Rivercraft911/PEEP/PCB/peep/production/REV1.1_bom.csv

Designator | Footprint | Quantity | Value | LCSC Part #
C2, C3 | 0402 | 2 | 1uF
C5, C7 | 0402 | 2 | 100nF
C6 | 0603 | 1 | 4.7uF
D1 | VEMD10940F | 1 | VEMD10940F | VEMD10940F
J1 | PCB_USBA | 1 | USB_A
R1 | 0402 | 1 | 10k
R2, R3 | Spacer_0805_SideMount_RC0805JR-070RL | 2 | R_US | C96345
TP1, TP2 | TestPoint-1.0mm | 2 | TestPoint
U1 | ST_UFQFPN28_4x4mm_P0.5mm | 1 | STM32F042G6Ux
U2 | Texas_X2SON-4_1x1mm_P0.65mm | 1 | TPS7A0233DQNR
U3 | VSOP38338 | 1 | VSOP38338 | VSOP38338
