Rivercraft911/PEEP/PCB/peep/peep.kicad_pcb

## KiCad design PCB/peep/peep.kicad_pcb (2026-08-11)

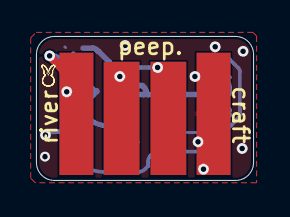
[picture p6: board peep.kicad_pcb from above]

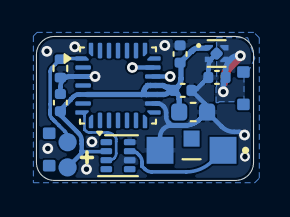
[picture p7: board peep.kicad_pcb from below]

Board: 4 copper layers, 12.1 x 8.0 mm, 15 parts (14 on the bottom side), 8 nets.

Parts:
C2, C3: 1uF; C_0402_1005Metric
C5, C7: 100nF; C_0402_1005Metric
C6: 4.7uF; C_0603_1608Metric
D1: VEMD10940F
J1: USB_A; PCB_USBA
R1: 10k; R_0402_1005Metric
R2, R3: R_US; Spacer_0805_SideMount_RC0805JR-070RL
TP1, TP2: TestPoint; TestPoint-1.0mm
U1: STM32F042G6Ux; ST_UFQFPN28_4x4mm_P0.5mm
U2: TPS7A0233DQNR; Texas_X2SON-4_1x1mm_P0.65mm
U3: VSOP38338

Connections:
+3V3: C3.2, C5.2, C6.2, C7.2, TP2.1 (1_1), U1.5 (VDDA), U1.17 (VDD), U1.18 (VDDIO2), U2.1 (OUT), U3.2 (VS)
+5V: C2.1, J1.1 (VBUS), U2.3 (EN), U2.4 (IN)
/BOOT0: R1.2, TP1.1 (1_1), U1.1 (PB8)
/OptoOut: U1.7 (PA1), U3.3 (~OUT)
/USB_D+: J1.3 (D+), U1.20 (PA10/PA12)
/USB_D-: J1.2 (D-), U1.19 (PA9/PA11)
GND: C2.2, C3.1, C5.1, C6.1, C7.1, D1.A, J1.4 (GND), R1.1, U1.3 (PF1), U1.16 (VSSA), U2.2 (GND), U2.5 (EP), U3.6 (GND), U3.8 (GND)
unnamed: D1.C, U3.7 (IN)
