Rivercraft911/PEEP/software/firmware/src/board.c

#include "board.h"

#include "stm32f0xx.h"

static volatile uint32_t ticks;

static void clock_init(void)
{
    FLASH->ACR = FLASH_ACR_PRFTBE | FLASH_ACR_LATENCY;

    RCC->CR2 |= RCC_CR2_HSI48ON;
    while ((RCC->CR2 & RCC_CR2_HSI48RDY) == 0U) {
    }

    RCC->CFGR = (RCC->CFGR & ~(RCC_CFGR_SW | RCC_CFGR_HPRE | RCC_CFGR_PPRE)) |
                RCC_CFGR_SW_HSI48;
    while ((RCC->CFGR & RCC_CFGR_SWS) != RCC_CFGR_SWS_HSI48) {
    }

    SystemCoreClock = 48000000U;
    RCC->AHBENR |= RCC_AHBENR_GPIOAEN;
    RCC->APB2ENR |= RCC_APB2ENR_SYSCFGEN;
    RCC->APB1ENR |= RCC_APB1ENR_CRSEN | RCC_APB1ENR_USBEN;
    RCC->CFGR3 &= ~RCC_CFGR3_USBSW;

    SYSCFG->CFGR1 |= SYSCFG_CFGR1_PA11_PA12_RMP;
    CRS->CFGR = 47999U | (34U << CRS_CFGR_FELIM_Pos) | CRS_CFGR_SYNCSRC_1;
    CRS->CR |= CRS_CR_AUTOTRIMEN | CRS_CR_CEN;
}

void board_init(void)
{
    clock_init();
    SysTick_Config(SystemCoreClock / 1000U);
}

uint32_t board_millis(void)
{
    return ticks;
}

/* Run from RAM while erasing the first flash page to force ROM boot on reset. */
__attribute__((section(".ramfunc"), noinline)) void board_enter_bootloader(void)
{
    __disable_irq();
    SysTick->CTRL = 0;
    SysTick->LOAD = 0;
    SysTick->VAL = 0;
    NVIC->ICER[0] = UINT32_MAX;
    NVIC->ICPR[0] = UINT32_MAX;

    while ((FLASH->SR & FLASH_SR_BSY) != 0U) {
    }
    if ((FLASH->CR & FLASH_CR_LOCK) != 0U) {
        FLASH->KEYR = FLASH_KEY1;
        FLASH->KEYR = FLASH_KEY2;
    }
    FLASH->SR = FLASH_SR_EOP | FLASH_SR_PGERR | FLASH_SR_WRPRTERR;
    FLASH->CR = FLASH_CR_PER;
    FLASH->AR = FLASH_BASE;
    FLASH->CR |= FLASH_CR_STRT;
    while ((FLASH->SR & FLASH_SR_BSY) != 0U) {
    }
    FLASH->CR = FLASH_CR_LOCK;

    __DSB();
    SCB->AIRCR = (0x5FAUL << SCB_AIRCR_VECTKEY_Pos) |
                 SCB_AIRCR_SYSRESETREQ_Msk;
    __DSB();
    for (;;) {
        __NOP();
    }
}

uint32_t tusb_time_millis_api(void)
{
    return board_millis();
}

void SysTick_Handler(void)
{
    ++ticks;
}
