Rivercraft911/PEEP/(commit log)

2026-08-11 PCB cooking
2026-08-25 Board bringup
2026-08-26 Startup timer
2026-08-26 Timer test
